rothestar/Danish-Artemis-bridge-build/Fighter/untitled.11.jpg

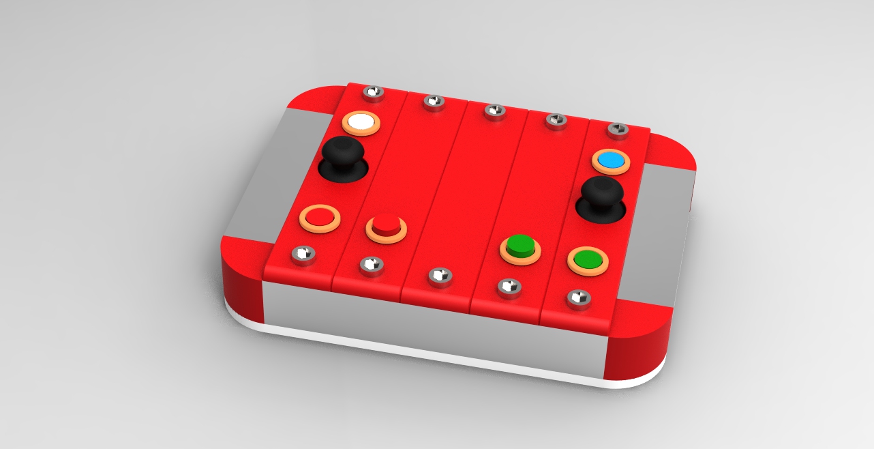
Fighter/untitled.11.jpg
