rothestar/Danish-Artemis-bridge-build/README.md

# Danish-Artemis-bridge-build
Files for the custom controls for my artemis bridge build
