rothestar/Danish-Artemis-bridge-build/engineering/untitled.19.jpg

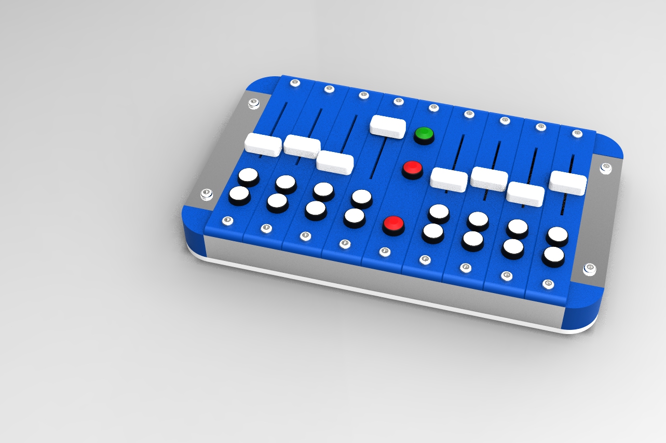
engineering/untitled.19.jpg
