rothestar/Danish-Artemis-bridge-build/Fighter/fighter drill plan.png

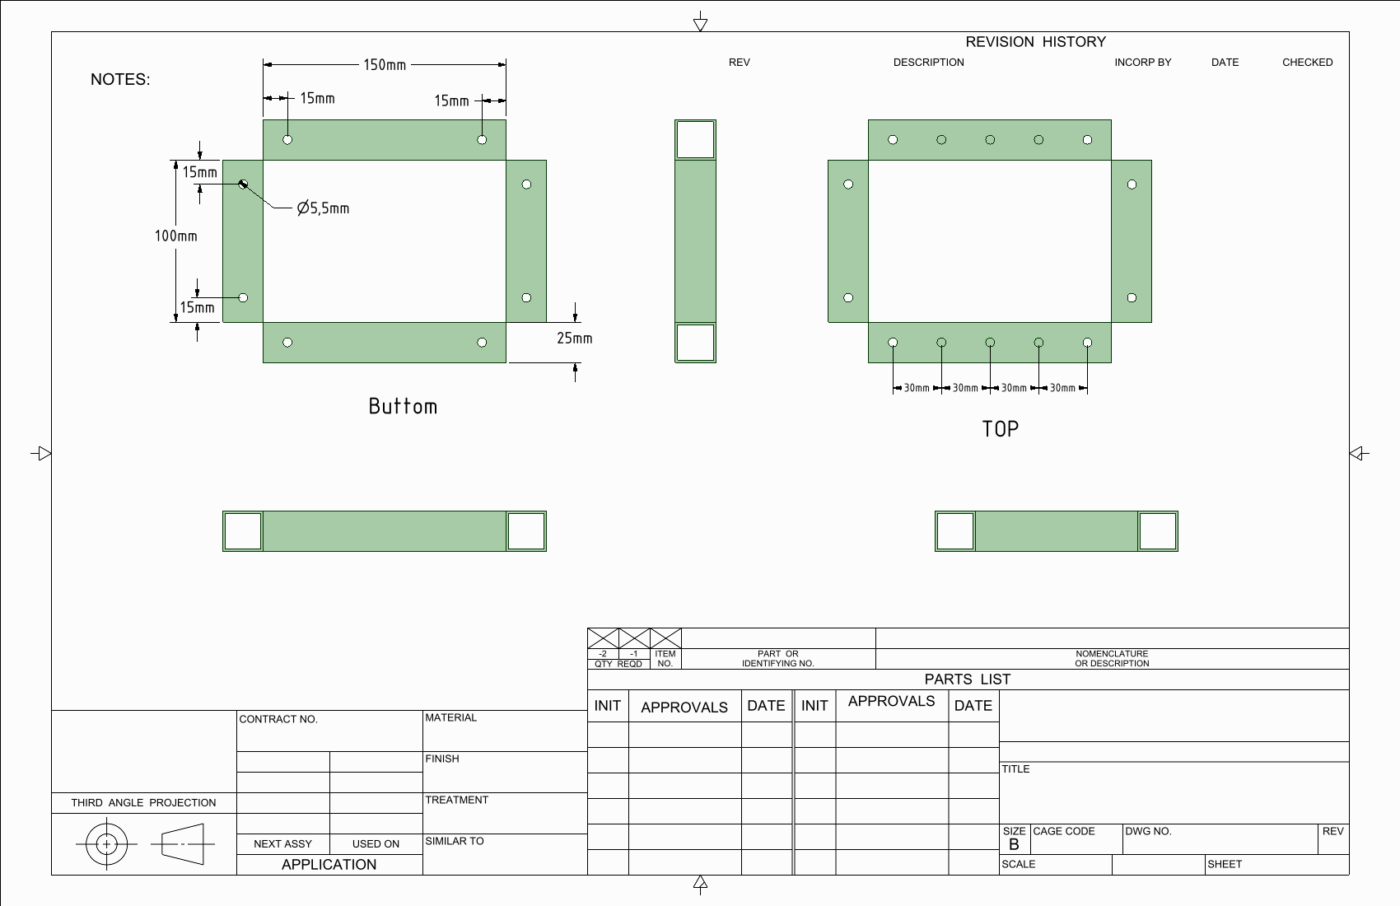
Fighter/fighter drill plan.png
