rothestar/Danish-Artemis-bridge-build/engineering/enginering slider frame  v2.stl

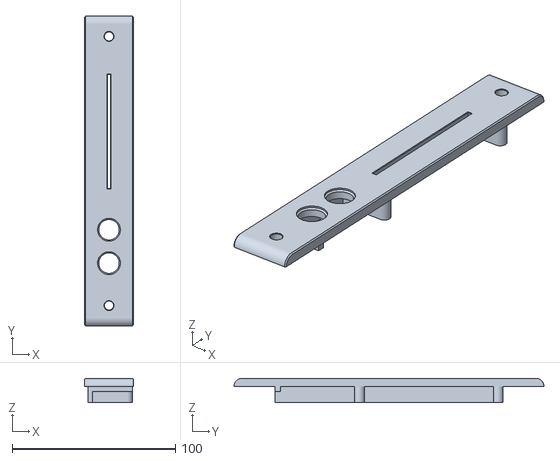
[picture p21: CAD file, 2018-02-26]
engineering/enginering slider frame v2.stl
30.0 x 190.0 x 15.0
