rothestar/Danish-Artemis-bridge-build/Fighter/fighter base plate.dxf

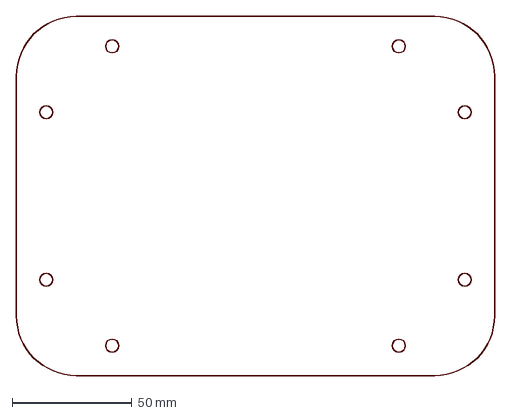
[picture p22: CAD file, 2017-08-21]
Fighter/fighter base plate.dxf
199.8 x 150.0 mm
