rothestar/Danish-Artemis-bridge-build/engineering/enginering button frame  v2.stl

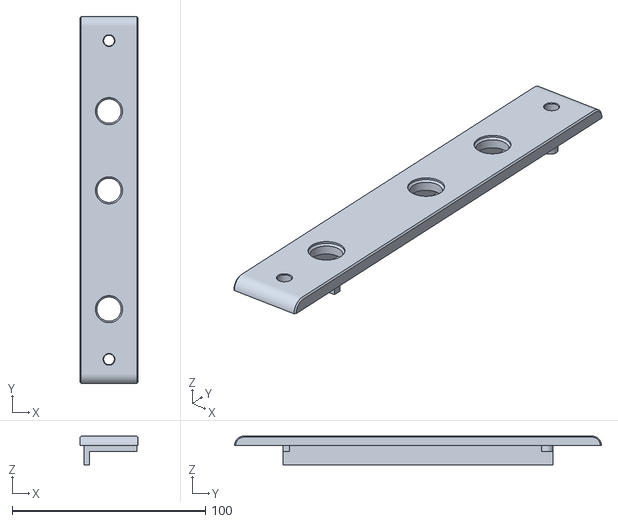
[picture p23: CAD file, 2018-02-26]
engineering/enginering button frame v2.stl
30.0 x 190.0 x 15.0
