rothestar/Danish-Artemis-bridge-build/Fighter/joystick bracket FINAL.stl

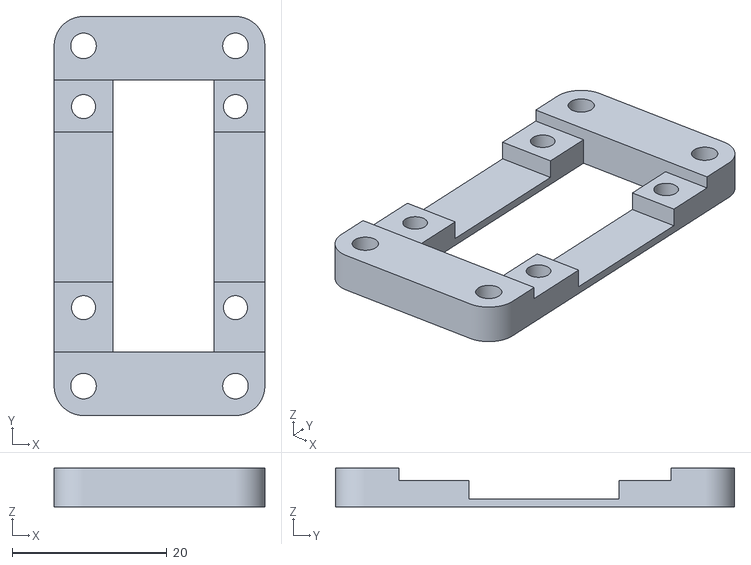
[picture p24: CAD file, 2017-08-21]
Fighter/joystick bracket FINAL.stl
27.3 x 51.6 x 5.00
