rothestar/Danish-Artemis-bridge-build/engineering/enginering blank frame v2.stl

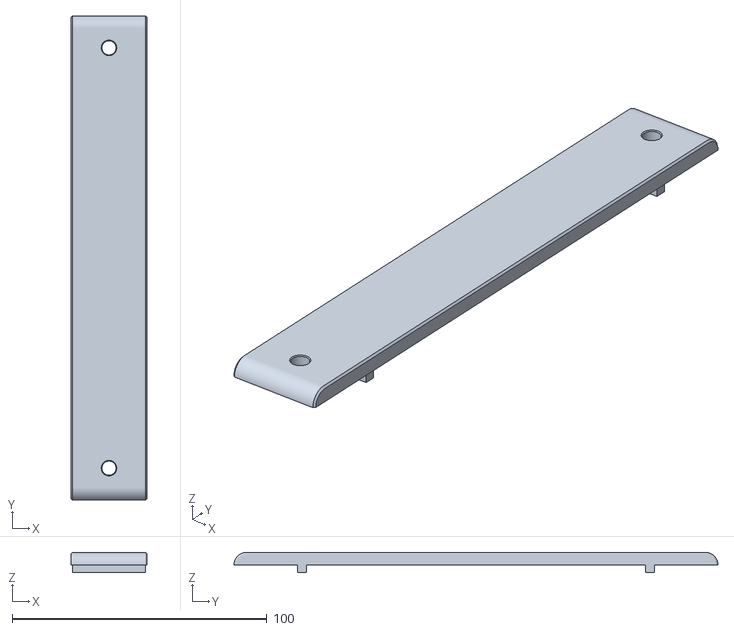
[picture p25: CAD file, 2018-02-26]
engineering/enginering blank frame v2.stl
30.0 x 190.0 x 8.00
