rothestar/Danish-Artemis-bridge-build/Fighter/Frame 3 blank.stl

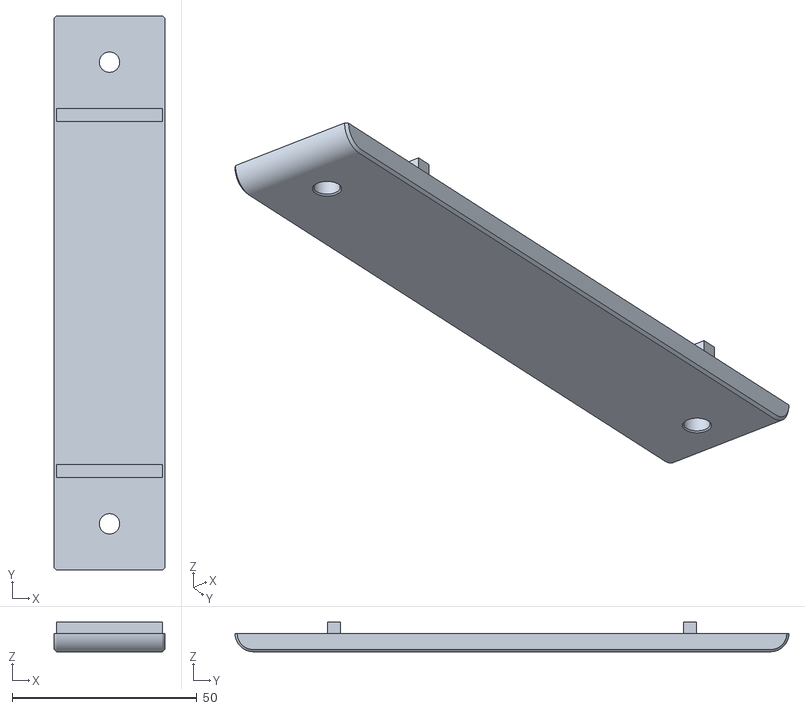
[picture p26: CAD file, 2017-08-21]
Fighter/Frame 3 blank.stl
30.0 x 150.0 x 8.00
