rothestar/Danish-Artemis-bridge-build/engineering/corner assenbly FINAL v2.stl

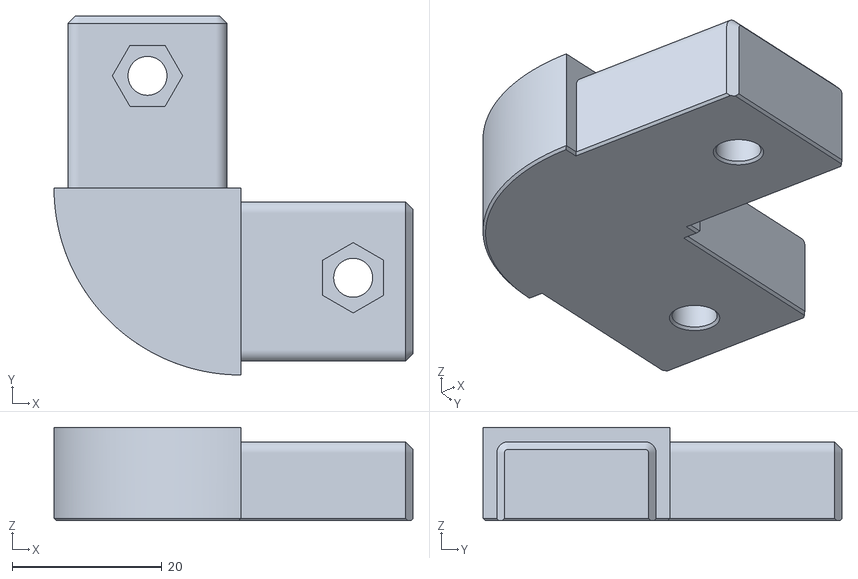
[picture p27: CAD file, 2018-02-26]
engineering/corner assenbly FINAL v2.stl
48.0 x 48.0 x 12.5
