rothestar/Danish-Artemis-bridge-build/Fighter/Frame 1 joystick.stl

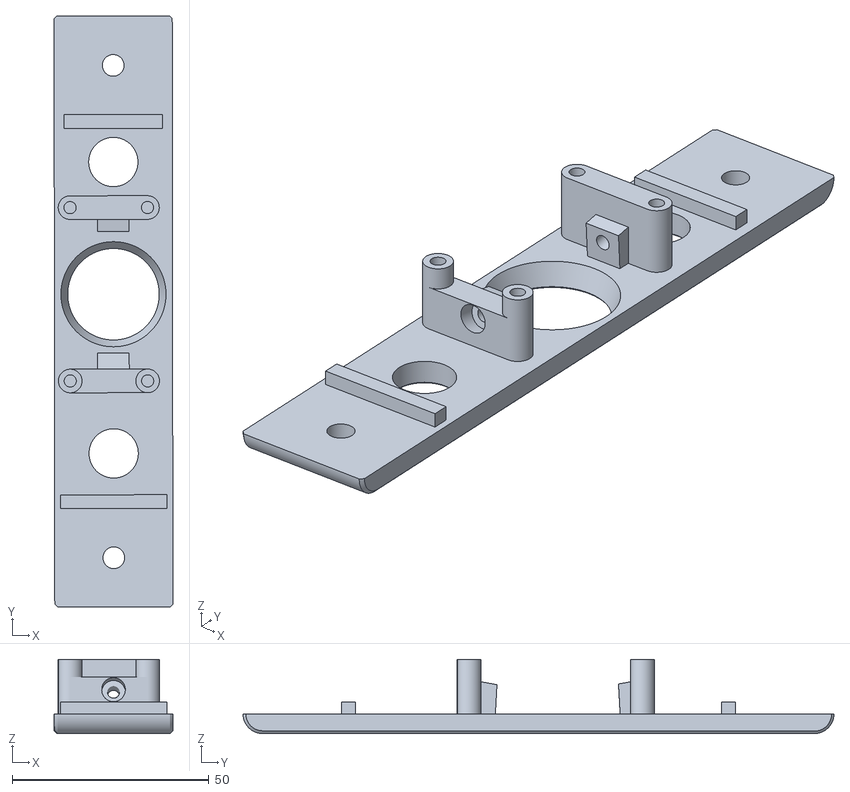
[picture p28: CAD file, 2017-08-21]
Fighter/Frame 1 joystick.stl
30.2 x 150.0 x 18.8
