rothestar/Danish-Artemis-bridge-build/(commit log)

2017-08-21 file for milling the baseplate
    [fighter base plate.dxf]
2018-02-26 Create STL files
